bagdades/tester/tester/Sprint-Layout60_rus/titel.bmp

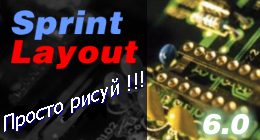
tester/Sprint-Layout60_rus/titel.bmp
