bagdades/tester/tester/RusPlan50/Titel.bmp

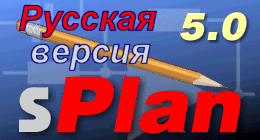
tester/RusPlan50/Titel.bmp
