bagdades/tester/(list of files, drawings)

Other design files:
tester/007.lay
tester/Sprint-Layout60_rus/MAKROS/ЭЛЕКТРО-ТЕХНИЧЕСКОЕ РАСПОЛОЖЕНИЕ ВЫВОДОВ/ПЕРЕХОДНИКИ/1.lay
