bagdades/tester/kicad/tester.kicad_pcb

## KiCad design kicad/tester.kicad_pcb (2018-04-10)

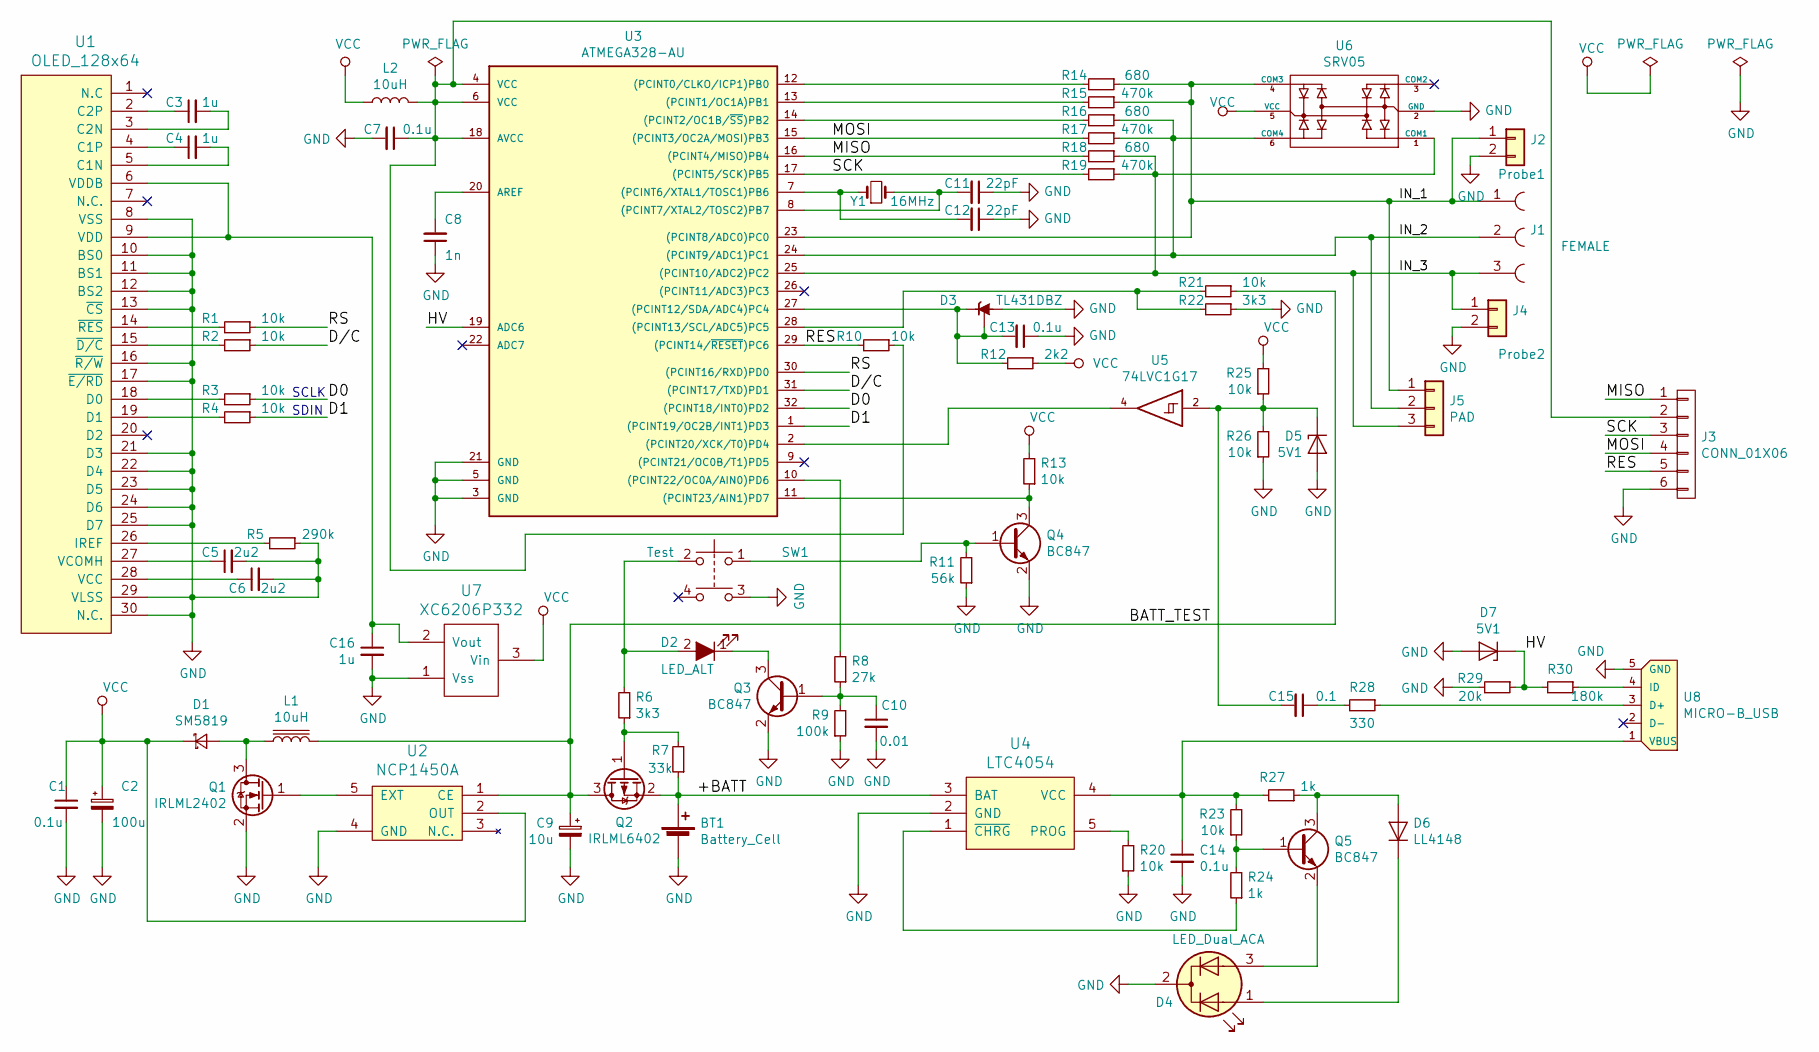
[picture p90: schematic tester.sch]

Parts:
BT1: Battery_Cell; PinHeader_1x02_P2.54mm_Vertical
C1, C7, C13, C14: 0.1u; C_0603_1608Metric
C2: 100u; c_tant_B
C3, C4, C16: 1u; C_0603_1608Metric
C5, C6: 2u2; C_0603_1608Metric
C8: 1n; C_0603_1608Metric
C9: 10u; c_tant_A
C10: 0.01; C_0603_1608Metric
C11, C12: 22pF; C_0603_1608Metric
C15: 0.1; C_0603_1608Metric
D1: SM5819; melf
D2: LED_ALT; LED_D3.0mm
D3: TL431DBZ; SOT-23
D4: LED_Dual_ACA; LED_D3.0mm-3
D5, D7: 5V1; D_MiniMELF
D6: LL4148; D_MiniMELF
J1: FEMALE; PinSocket_1x03_P2.54mm_Vertical
J2: Probe1; conn_tester
J3: CONN_01X06; avr_spi
J4: Probe2; conn_tester
J5: PAD; conn_threepoint
L1: 10uH; L_Coilcraft_XAL5030
L2: 10uH; L_0805_2012Metric
Q1: IRLML2402; SOT-23
Q2: IRLML6402; SOT-23
Q3, Q4, Q5: BC847; SOT-23
R1, R2, R3, R4, R10, R13, R20, R21, R23, R25, R26: 10k; R_0603_1608Metric
R5: 290k; R_0603_1608Metric
R6, R22: 3k3; R_0603_1608Metric
R7: 33k; R_0603_1608Metric
R8: 27k; R_0603_1608Metric
R9: 100k; R_0603_1608Metric
R11: 56k; R_0603_1608Metric
R12: 2k2; R_0603_1608Metric
R14, R16, R18: 680; R_1206_3216Metric
R15, R17, R19: 470k; R_1206_3216Metric
R24, R27: 1k; R_0603_1608Metric
R28: 330; R_0603_1608Metric
R29: 20k; R_0603_1608Metric
R30: 180k; R_0603_1608Metric
SW1: Test; BUT6120
U1: OLED_128x64; oled
U2: NCP1450A; SOT-23-5
U3: ATMEGA328-AU; TQFP-32_7x7mm_P0.8mm
U4: LTC4054; SOT-23-5
U5: 74LVC1G17; SOT-23-5
U6: SRV05; SOT-23-6
U7: XC6206P332; SOT-23
U8: MICRO-B_USB; USB_Micro-B_Molex_47346-0001
Y1: 16MHz; crystal_hc-49s

Connections:
/+BATT: BT1.1 (+), Q2.2 (S), R7.1, U4.3 (BAT)
/BATT_TEST: C9.1, L1.2, Q2.3 (D), R21.1, U2.1 (CE)
/D0: R3.1, U3.32 ((PCINT18/INT0)PD2)
/D1: R4.1, U3.1 ((PCINT19/OC2B/INT1)PD3)
/D/C: R2.1, U3.31 ((PCINT17/TXD)PD1)
/HV: D7.1 (K), R29.1, R30.2, U3.19 (ADC6)
/IN_1: J1.1, J2.1, J5.1, R14.1, R15.1, U3.23 ((PCINT8/ADC0)PC0), U6.4 (COM3)
/IN_2: J1.2, J5.2, R16.1, R17.1, U3.24 ((PCINT9/ADC1)PC1), U6.6 (COM4)
/IN_3: J1.3, J4.1, J5.3, R18.1, R19.1, U3.25 ((PCINT10/ADC2)PC2), U6.1 (COM1)
/MISO: J3.1, R18.2, U3.16 ((PCINT4/MISO)PB4)
/MOSI: J3.4, R17.2, U3.15 ((PCINT3/OC2A/MOSI)PB3)
/RES: J3.5, R10.2, U3.29 ((PCINT14/~RESET~)PC6)
/RS: R1.1, U3.30 ((PCINT16/RXD)PD0)
/SCK: J3.3, R19.2, U3.17 ((PCINT5/SCK)PB5)
GND: BT1.2 (-), C1.2, C2.2, C5.2, C6.2, C7.2, C8.1, C9.2, C10.2, C11.1, C12.1, C13.1, C14.2, C16.2, D3.3 (A), D4.2 (K), D5.2 (A), D7.2 (A), J2.2, J3.6, J4.2, Q1.2 (S), Q3.2 (E), Q4.2 (E), R5.1, R9.1, R11.1, R20.1, R22.1, R26.1, R29.2, SW1.3, U1.8 (VSS), U1.10 (BS0), U1.11 (BS1), U1.12 (BS2), U1.13 (~CS), U1.16 (~R/W), U1.17 (~E/RD), U1.21 (D3), U1.22 (D4), U1.23 (D5), U1.24 (D6), U1.25 (D7), U1.29 (VLSS), U1.30 (N.C.), U2.4 (GND), U3.3 (GND), U3.5 (GND), U3.21 (GND), U4.2 (GND), U5.3 (GND), U6.2 (GND), U7.1 (Vss), U8.5 (GND)
unnamed: C3.1, U1.2 (C2P)
unnamed: C3.2, U1.3 (C2N)
unnamed: C4.1, U1.4 (C1P)
unnamed: C4.2, U1.5 (C1N)
unnamed: C5.1, U1.27 (VCOMH)
unnamed: C6.1, U1.28 (VCC)
unnamed: C7.1, J3.2, L2.2, R10.1, U3.4 (VCC), U3.6 (VCC), U3.18 (AVCC)
unnamed: C8.2, U3.20 (AREF)
unnamed: C10.1, Q3.1 (B), R8.1, R9.2
unnamed: C11.2, U3.8 ((PCINT7/XTAL2/TOSC2)PB7), Y1.2
unnamed: C12.2, U3.7 ((PCINT6/XTAL1/TOSC1)PB6), Y1.1
unnamed: C13.2, D3.1 (K), D3.2 (REF), R12.2, U3.27 ((PCINT12/SDA/ADC4)PC4)
unnamed: C14.1, R23.2, R27.2, U4.4 (VCC), U8.1 (VBUS)
unnamed: C15.1, R28.2
unnamed: C15.2, D5.1 (K), R25.1, R26.2, U5.2
unnamed: C16.1, U1.6 (VDDB), U1.9 (VDD), U7.2 (Vout)
unnamed: D1.2 (A), L1.1, Q1.3 (D)
unnamed: D2.1 (K), Q3.3 (C)
unnamed: D2.2 (A), R6.2, SW1.2
unnamed: D4.1 (A1), D6.1 (K)
unnamed: D4.3 (A2), Q5.2 (E)
unnamed: D6.2 (A), Q5.3 (C), R27.1
unnamed: Q1.1 (G), U2.5 (EXT)
unnamed: Q2.1 (G), R6.1, R7.2
unnamed: Q4.1 (B), R11.2, SW1.1
unnamed: Q4.3 (C), R13.1, U3.11 ((PCINT23/AIN1)PD7)
unnamed: Q5.1 (B), R23.1, R24.2
unnamed: R1.2, U1.14 (~RES)
unnamed: R2.2, U1.15 (~D/C)
unnamed: R3.2, U1.18 (D0)
unnamed: R4.2, U1.19 (D1)
unnamed: R5.2, U1.26 (IREF)
unnamed: R8.2, U3.10 ((PCINT22/OC0A/AIN0)PD6)
unnamed: R14.2, U3.12 ((PCINT0/CLKO/ICP1)PB0)
unnamed: R15.2, U3.13 ((PCINT1/OC1A)PB1)
unnamed: R16.2, U3.14 ((PCINT2/OC1B/~SS~)PB2)
unnamed: R20.2, U4.5 (PROG)
unnamed: R21.2, R22.2, U3.28 ((PCINT13/SCL/ADC5)PC5)
unnamed: R24.1, U4.1 (~CHRG)
unnamed: R28.1, U8.3 (D+)
unnamed: R30.1, U8.4 (ID)
unnamed: U3.2 ((PCINT20/XCK/T0)PD4), U5.4
VCC: C1.1, C2.1, D1.1 (K), L2.1, R12.1, R13.2, R25.2, U2.2 (OUT), U5.5 (VCC), U6.5 (VCC), U7.3 (Vin)

Notes on the sheet:
SCLK
SDIN

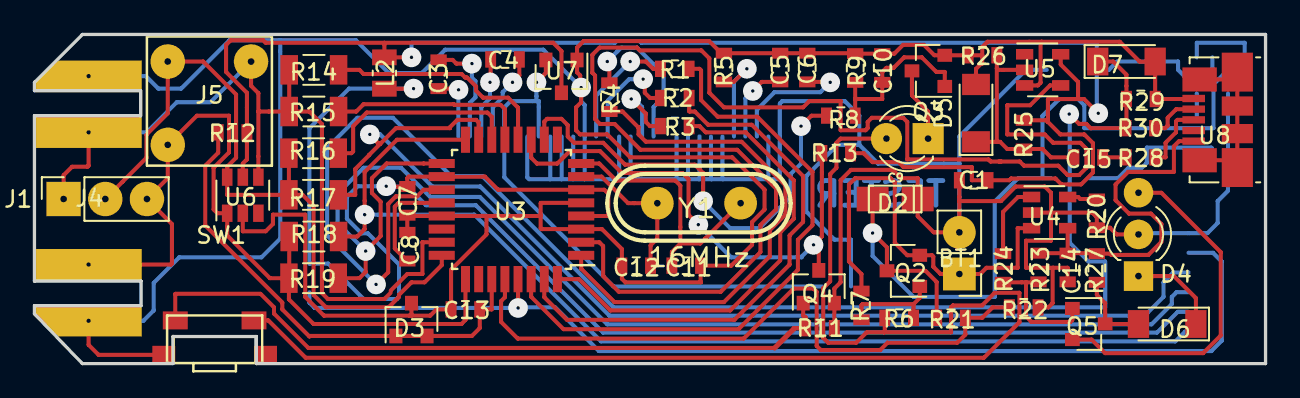
[picture p91: board tester.kicad_pcb from above]

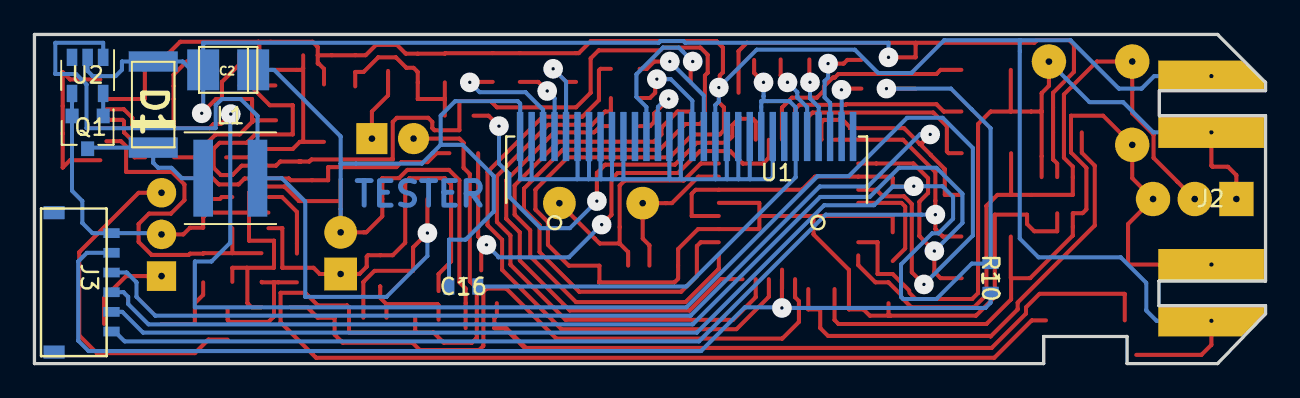
[picture p92: board tester.kicad_pcb from below]

Board: 2 copper layers, 75.1 x 20.1 mm, 76 parts (10 on the bottom side), 58 nets.
