bagdades/tester/04/24x32update_bitmaps.h

#include <avr/pgmspace.h>



//*****************************************************************************
//
// The data for the bitmap bmp_p_e_igbt
// update of the bitmap bmp_n_e_igbt at location 12,0
//
// Memory usage: 38 bytes
//*****************************************************************************
#if defined (MAIN_C)
 #if (ICON_TYPE == 1) /* Nick's thin icon update */
 const unsigned char bmp_p_e_igbt[(6 * 4) + 4] PROGMEM =
{ 
 17,
  0,
  6,
 32,
 /*0x00, 0x00, 0x00, 0x00,  0x00, 0x00, 0x00, 0x00, 
  0x00, 0x00, 0x00, 0x00,  0x1E, 0x21, 0x21, 0x21, 
  0x12,*/0x40, 0xC0, 0xC0,  0xC0, 0xC0, 0x20,/* 0x1F,
 
  0x00, 0x3C, 0x42, 0x52,  0x52, 0x34, 0x00, 0x00, 
  0x00, 0x00, 0x00, 0x00,  0xF8, 0x00, 0x00, 0xDE, 
  0x88,*/0x04, 0x02, 0x01,  0x03, 0x07, 0x00,/* 0x00,
 
  0x00, 0x04, 0x04, 0x04,  0x04, 0x04, 0x04, 0x04, 
  0x04, 0x04, 0x04, 0x04,  0x07, 0x00, 0x00, 0x3D, 
  0x08,*/0x11, 0xE2, 0xE4,  0xE0, 0x60, 0x20,/* 0x00,
 
  0x00, 0x00, 0x00, 0x00,  0x00, 0x00, 0x00, 0x00, 
  0x00, 0x00, 0x00, 0x00,  0xFC, 0x94, 0x94, 0x94, 
  0x84,*/0x00, 0x03, 0x01,  0x00, 0x01, 0x02,/* 0xFC */  
}; /* P-e-igbt = N-E-IGBT1 + UPDATE */

 #elif (ICON_TYPE == 2) /* Nick's bold icon update */
 const unsigned char bmp_p_e_igbt[(7 * 4) + 4] PROGMEM =
{ 
 15,
 0,
 7,
 32,
 /* 0x00, 0x00, 0x00, 0x00, 0x00, 0x00, 0x00, 0x00,
  0x00, 0x3E, 0x41, 0x41, 0x41, 0x22, 0x00,*/ 0x00,
  0x10, 0xB0, 0xF0, 0xF0, 0xF0, 0xF8,/* 0x0F, 0x07,

  0x00, 0x3C, 0x42, 0x52, 0x52, 0x34, 0x00, 0x00,
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

        0x00, 0x00, 0x00, 0x00,  0x00, 0x00, 0x00, 0x00,
        0x00, 0x00, 0x00, 0x00,  0x00, 0xfc, 0x94, 0x94,
        0x94, 0x84, 0x00, 0x01,  0x03, 0x07, 0xfe, 0xfc, */
}; /* PNP = NPN0 + UPDATE */

#endif
#else
 extern const unsigned char bmp_pnp[] PROGMEM ;
#endif
