bagdades/tester/04/sampling_lc.c

// original June-Sept 2015, pa3fwm@amsat.org

#ifdef SamplingADC

#include <avr/io.h>
#include <stdlib.h>
#include "Transistortester.h"

typedef uint8_t byte;

uint32_t lc_fx;      // measured resonant frequency (in Hz)
uint16_t lc_qx;      // measured resonance Q (in units of 0.1)
uint32_t lc_lx;      // measured inductance using the samplingADC method (in nH)
uint16_t lc_cpartmp; 
#ifndef CxL 
 #define CxL 18040			//default value for parallel capacitor for inductance measurement
#endif
const uint16_t lc_cpar_ee EEMEM = CxL;         // place for lc_cpar as calibration constant in eeprom




#define Maxpk 20

static unsigned int peaksearch(unsigned int uu[], unsigned int *qptr, byte dist, byte maxpk)
// searches uu[256] for peaks, using averaging over dist samples (dist should be about 1/4 of the expected period)
// writes measured Q *10 into *qptr if non-NULL
// maxpk is maximum number of peaks to take into account
// if maxpk<=2, indicates preliminary search mode, where dist may not yet be approximately correct; less stringent filtering then
// returns measured period, with 6 bits of fraction, or 0 if no resonance found
{  
   unsigned int a=0;  // moving average of previous dist points
   unsigned int b=0;  // moving average of next dist points
   byte i;        // index in uu[]
   byte ipk=0;    // peak count
   int prevdelta=1;
   unsigned int firstpeak=0;      // height of first peak
   unsigned int prevpeak=0;       // height of previous peak
   unsigned int sumpeak=0;        // sum of peaks
   unsigned int firstpeakx=0;     // time of first peak, with 6 bits of fraction
   unsigned int prevpeakx=0;      // time of previous peak, with 6 bits of fraction
   unsigned short firstzero=0;    // time of first zero, used for sanity check
   byte sawzero=0;                // flag: did we already encounter a zero?
//         uart_putc('d'); uart_int(dist); uart_newline();

   for (i=0;i<255-dist;i++) 
   {
      b+=uu[i+dist];
      a+=uu[i];
      if (i<dist) continue;
      a-=uu[i-dist];
      b-=uu[i];
      int delta=a-b;
      if (a==0) {
         sawzero=1;
         if (!firstzero) firstzero=i-dist;
      }
//         if (maxpk>2-2) { wdt_reset(); uart_putc('b'); uart_int(a); uart_int(b); uart_newline();}

      // note: uu[] can be assumed < 600 or so, since we're not interested in peaks above some 600 mV
      // with dist<=32 (because at least 2 periods must fit in 256 samples)
      // this means a and b cannot exceed about +20000, and cannot be negative
      // delta is between -20000 and 20000; near zero crossing delta can't exceed one uu[] value, i.e. +/- 600
      // delta can therefore safely be shifted <<6, but not <<8
      // hence the 6 bits of fraction in the peak location
      // on my atmega328p, in some cases most measured peak intervals differ by less than about 0.05, so 6 bits of fraction is just enough to not lose precision
      if (delta>0 && prevdelta<=0 && i>2*dist-1) {
         // found (local) maximum
//         myuart_putc('p'); myuart_putc(' ');  uart_int(i); uart_int(a+b); uart_int(dist); uart_newline();
         if (a+b < 3*dist) break;  // stop if peak not significantly high
         unsigned x = (i<<6) - ((delta<<6)+(1<<5))/(delta-prevdelta);
//         if (maxpk>2-2) { uart_putc('E'); uart_int(x); uart_int(ipk); uart_int(sawzero); uart_int(dist); uart_newline(); }

         sumpeak+=a+b;
         if (ipk==0) {
            firstpeak=a+b;
            firstpeakx=x;
         } else if (dist!=1) {
            // sanity check: distance between peaks is expected to be 4*dist samples, so if >=8*dist it's suspicious
            byte tmp;       // use this intermediate variable to force compiler to use 8-bit arithmetic
            tmp=x>>8;
            tmp-=prevpeakx>>8;    // tmp now is peak distance in units of 4 samples
            if (tmp>(dist<<1)) break;
         }
         if (!sawzero) {           // stop if the signal has not been zero since previous peak
            if (maxpk>2) break;
            else goto skip;        // if we're still in preliminary search mode: just skip this peak hoping we'll find a real one later
         }
         sawzero=0;
         prevpeak=a+b;
//         if (maxpk>2) { myuart_putc('e'); myuart_putc(' '); uart_int(x-prevpeakx); uart_int(a+b); uart_int(x>>6); uart_newline(); }
         prevpeakx=x;
         ipk++;
         if (ipk==maxpk) break;
      }
skip:
      prevdelta=delta;
   } /* end for i */

   if (qptr) {
      // calculate r = ratio of amplitude between two consecutive peaks (*1000 for scaling)
      // but we use all peaks seen in this calculation for better accuracy
      // r is weighted average of peak2/peak1, peak3/peak2 and so on, weighed by respectively peak1, peak2 and so on
      // this can be calculated as r = (peak2+peak3+...+peak_m)/(peak1+peak2+peak_{m-1})
      unsigned long int r=((sumpeak-firstpeak)*1000ul)/(sumpeak-prevpeak);
      // r = exp(-pi/Q)  so Q = -pi/(ln(r))
      // for r almost 1 (i.e., high Q), this is approx. pi/(1-r)
      r = 31416u/get_log(1000-r);
      // note scaling: the get_log is *1000, and we now compute Q in multiples of .1, hence the numerator being 10000*pi
      *qptr=(unsigned int)r;
   }
   if (ipk<2) return 0;		// only one or no peak found
   ipk--;
   unsigned int per= (prevpeakx-firstpeakx+(ipk>>1))/ipk;   // average period; the (ipk>>1) provides for rounding
   if (firstzero>(per>>6)) return 0;     // sanity check: first zero should be within first period
   return per;
}  /* end of peaksearch */




void sampling_lc(byte LowPin, byte HighPin)
{
   uint16_t lc_cpar;    // value of parallel capacitor used for calculating inductance, in pF
   lc_cpar=eeprom_read_word((uint16_t *)&lc_cpar_ee);

//###################################################################################################
//#ifndef SamplingADC_CNT             // old version of the code
#if 0

   byte HiPinR_L, LoADC;
   HiPinR_L = pgm_read_byte(&PinRLRHADCtab[HighPin]);	//R_L mask for HighPin R_L load
#if (((PIN_RL1 + 1) != PIN_RH1) || ((PIN_RL2 + 1) != PIN_RH2) || ((PIN_RL3 + 1) != PIN_RH3))
   LoADC = pgm_read_byte((&PinRLRHADCtab[6])+LowPin) | TXD_MSK;
#else
   LoADC = pgm_read_byte((&PinRLRHADCtab[3])+LowPin) | TXD_MSK;
#endif

   lc_fx=0;
   lc_qx=0;
   lc_lx=0;
   if ((PartFound != PART_RESISTOR) || (inductor_lpre > 0)) {
      // can happen if we're invoke when there's both a diode and a resistor;
      // don't try to measure inductance then
      // the other reason is a too big resistance, 2100 Ohm is found by ReadInductance
      return;
   }

   byte i=0;

   unsigned int uu[257];
   ADC_PORT = TXD_VAL;
   ADC_DDR = LoADC;			// switch Low-Pin to output (GND)
   wait100us();


   // first, acquire data at maximum speed:
#if (PROCESSOR_TYP == 644) || (PROCESSOR_TYP == 1280)
   ADMUX=HighPin|(0<<REFS0)|(1<<REFS1);   // use built-in reference, about 1.1 V;
#else
   ADMUX=HighPin|(1<<REFS0)|(1<<REFS1);   // use built-in reference, about 1.1 V;
   // that's enough, because peaks more than about 0.6 V are not of interest
   // (because the negative peak would be chopped by the protection diodes)
#endif
#ifdef NO_AREF_CAP
    wait100us(); /* time for voltage stabilization */
#else
    wait_about10ms(); /* time for voltage stabilization */
#endif
    samplingADC(0, uu, 0, HiPinR_L, 0, HiPinR_L, HiPinR_L);     // floats the HiPin during measurement, thus not loading the tuned circuit
//   uart_newline(); for (i=0;i<255;i++) { uart_putc('A'); uart_putc(' '); uart_int(uu[i]); uart_newline(); wdt_reset(); }

   byte dist0;
   unsigned shift=0;
   // check how long until signal reaches 0: that gives us a first guess of 1/4 of the resonance period (because we apply an impulse, so we start at the maximum of the sinewave)
   for (dist0=2;dist0<250;dist0++) if (uu[dist0]==0) break;
   if (dist0==250) {
      // no periodicity seen, so no valid results
//      lc_lx=0;
//      lc_fx=0;
//      lc_qx=0;
      return;
   }

   dist0--;                 // improves estimate slightly (experimentally)
   uint16_t par = samplingADC_twopulses | (4<<smplADC_inter_pulse_width); // default: two pulses at minimal distance
   if (dist0<=6*3) {
      // in case of rather small dist0, need to measure dist0 more precisely, by simply invoking the peaksearch function
      unsigned int full_per;
retry:
      full_per=peaksearch(uu,NULL,dist0,2);
//         uart_putc('p'); uart_int(per); uart_newline();
      if (full_per==0) {   // not at least 2 peaks found: try with smaller dist0, or give up
                      // reason for trying with small dist0 is that with very small inductors, zero is often not reached before the first peak, making the zeroth peak look much too wide, causing overestimate of dist0
                      // perhaps should no longer use that for estimating dist0...
         if (dist0>2) { dist0=2; goto retry; }
         return;  
      }
      dist0= 1+(full_per>>8);    // >>6 because of fraction bits, plus >>2 because dist0 should be about a quarter period, plus +1 since 2 turns out to work better than 1 even on very fast signals (2 MHz or so)
      full_per>>=6;
      if (full_per<=15) {
         // for high frequencies, we can send 2 pulses at the appropriate interval
         // (for lower frequencies, we just keep them at their default minimum distance)
         if (full_per<4) full_per=4;
         par = samplingADC_twopulses | (((byte)full_per)<<smplADC_inter_pulse_width);
      }
   }
//   uart_newline(); for (i=0;i<255;i++) { uart_putc('a'); uart_putc(' '); uart_int(uu[i]); uart_newline(); wdt_reset(); }
	
   if (dist0>16) {
      // rather slow resonance: then re-sample with 4 or 16 times larger interval; shift variable serves to take this into account in later calculations
      if (dist0<64) {
         shift=2;
         par = samplingADC_slow4 | samplingADC_twopulses | (4<<smplADC_inter_pulse_width);
      } else {
         shift=4;
         par = samplingADC_slow16 | samplingADC_twopulses | (4<<smplADC_inter_pulse_width);
      }
      dist0>>=shift;
   }
   // we take the average of 8 measurements, to increase S/N, except when using slow16 mode, since then the sampling would take annoyingly long (and S/N usually is better anyway at these lower frequencies)
   
//      par |= samplingADC_cumul;
   for (i=0;i<8;i++) {
      wdt_reset();
      samplingADC(par, uu, 0, HiPinR_L, 0, HiPinR_L, HiPinR_L);
      if (par & samplingADC_slow16) goto noavg;
      par |= samplingADC_cumul;
   }
   for (i=0;i<255;i++) uu[i]>>=3;   // divide all samples by 8

#ifndef SamplingADC_CNT
noavg:;
#endif
//***************************************************************************************************
#if (DEB_SAM == 2)
   uint16_t ii;
//   for (ii=0;ii<256;ii+=4) {
   for (ii=0;ii<64;ii+=4) {
      if ((ii%32) == 0) {
         lcd_clear();
	 DisplayValue16(ii,0,'-',4);
	 lcd_space();
	 lcd_data('>');
	 lcd_data('>');
	 DisplayValue16(shift,0,' ',3);
	 DisplayValue16(par>>smplADC_inter_pulse_width,0,' ',3);
	 lcd_next_line_wait(0);
      } else{	 	lcd_next_line_wait(0); }
      DisplayValue16(uu[ii],0,' ',5);
      DisplayValue16(uu[ii+1],0,' ',5);
      DisplayValue16(uu[ii+2],0,' ',5);
      DisplayValue16(uu[ii+3],0,' ',5);
      if ((ii%32) == 28) {
	 lcd_clear_line();
	 lcd_refresh();
         wait_about5s();
      }
   } /* end for ii */
#endif
//***************************************************************************************************

//   uart_newline(); uart_putc('s'); uart_int(shift); uart_newline();  for (i=0;i<255;i++) { uart_putc('a'); uart_putc(' '); uart_int(uu[i]); uart_newline(); wdt_reset(); }

//         uart_putc('d'); uart_int(d); uart_newline();

//###################################################################################################
#else  // new version of the code, with pulses via the ADC port, i.e., without 680 ohm series resistor

   byte HiPinR_L, LoADC;
   HiPinR_L = pinmaskRL(HighPin);
   LoADC = pinmaskADC(LowPin);

   lc_fx=0;
   lc_qx=0;
   lc_lx=0;
   if ((PartFound != PART_RESISTOR) || (inductor_lpre > 0)) {
      // can happen if we're invoke when there's both a diode and a resistor;
      // don't try to measure inductance then
      // the other reason is a too big resistance, 2100 Ohm is found by ReadInductance
      return;
   }

   byte i=0;

   unsigned int uu[255];


   ADC_PORT = TXD_VAL;
   ADC_DDR = LoADC;			// switch Low-Pin to output (GND)
   wait100us();

   // first, acquire data at maximum speed:
   ADMUX=HighPin|ADref1V1;   // use built-in reference, about 1.1 V;
                             // that's enough, because peaks more than about 0.6 V are not of interest
                             // (because the negative peak would be chopped by the protection diodes)
   wait_aref_stabilize();                               

   // run a first measurement, using the narrow full-current impulse
   samplingADC((1<<smplADC_span)|(1<<smplADC_direct), uu, 255, HiPinR_L, 0, 0, HiPinR_L);

   // also measure some 20 samples at the "cold side" of the coil, and subtract
   // at highest frequencies, this is useful because the on-chip ADC has an RC lowpass which gives an exponentially decaying "DC" offset
   unsigned int uu0[20];
   ADMUX=LowPin|ADref1V1;   // switch to "cold" side for reference measurement
   samplingADC((1<<smplADC_span)|(1<<smplADC_direct), uu0, 20, HiPinR_L, 0, 0, HiPinR_L);
   for (i=0;i<20;i++)
   {
      if (uu[i]>=uu0[i]) uu[i]-=uu0[i];
      else uu[i]=0;
   }
   ADMUX=HighPin|ADref1V1;   // back to "hot" side

//   uart_newline(); for (i=0;i<255;i++) { myuart_putc('A'); myuart_putc(' '); uart_int(uu[i]); uart_int(uu0[i]); uart_newline(); wdt_reset(); }

   byte dist0;         // estimate of duration of 1/4 of a period, used to set averaging interval in peaksearch()
   unsigned shift=0;   // by how many bit positions measured period needs to be shifted due to measuring with span>1

   // check how long until signal reaches 0: that gives us a first guess of 1/4 of the resonance period (because we apply an impulse, so we start at the maximum of the sinewave)
   for (dist0=1;dist0<250;dist0++) if (uu[dist0]==0) break;
   if (dist0==250) return; // no periodicity seen, so no valid results
#if (DEB_SAM == 5)
   byte dist00;
   dist00 = dist0;
#endif

   uint16_t par = (1<<smplADC_span) | (1<<smplADC_direct); // default: one pulse 
   if (dist0<=16) {
      // in case of small dist0, need to measure dist0 more precisely, by simply invoking the peaksearch function
      // this includes the case dist0==0, which may happen with very small coils, when the response starts at 0 rather than with a peak
      unsigned int full_per;
      full_per=peaksearch(uu,NULL,dist0,2);
//       { myuart_putc('D'); myuart_putc(' '); uart_int(dist0); uart_int(full_per); uart_newline(); }
      dist0= 1+(full_per>>8);    // >>6 because of fraction bits, plus >>2 because dist0 should be about a quarter period, plus +1 to round up
   }
//   { myuart_putc('d'); myuart_putc(' '); uart_int(dist0); uart_newline(); }
	
#define samplingADC_direct (1<<smplADC_direct)
   par = (1<<smplADC_span) | samplingADC_direct;
   if (dist0>16) {
      // rather slow resonance: then re-sample with 4 or 16 times larger interval; shift variable serves to take this into account in later calculations
      if (dist0<64) {
         shift=2;
         par = (4<<smplADC_span) | samplingADC_direct;
//         par = 3 | (4<<smplADC_span);
      } else {
         shift=4;
         par = (16<<smplADC_span) | samplingADC_direct;
//         par = 15 | (16<<smplADC_span);
      }
      dist0>>=shift;
   }
#if (DEB_SAM == 5)
   uint16_t ii;
//   for (ii=0;ii<256;ii+=4) {
   for (ii=0;ii<255;ii+=4) {
      if ((ii%32) == 0) {
         lcd_clear();
	 DisplayValue16(ii,0,'-',4);
	 lcd_space();
	 lcd_data('>');
	 lcd_data('>');
	 DisplayValue16(shift,0,' ',3);
         DisplayValue16(dist0,0,' ',4);
         DisplayValue16(dist00,0,' ',4);
	 lcd_next_line_wait(0);
      } else{	 	lcd_next_line_wait(0); }
      DisplayValue16(uu[ii],0,' ',5);
      DisplayValue16(uu[ii+1],0,' ',5);
      DisplayValue16(uu[ii+2],0,' ',5);
      DisplayValue16(uu[ii+3],0,' ',5);
      if ((ii%32) == 28) {
	 lcd_clear_line();
	 lcd_refresh();
         wait_about1s();
      }
   } /* end for ii */
   lcd_refresh();
   wait_about1s();
#endif

   // we take the average of 8 measurements, to increase S/N, except when using span>1, since then the sampling takes annoyingly long and S/N usually is better anyway at these lower frequencies
   for (i=0;i<8;i++) {
      wdt_reset();
      samplingADC(par, uu, 255, HiPinR_L, 0, 0, HiPinR_L);
      if (par >> (smplADC_span+1)) goto noavg;
      par |= samplingADC_cumul;
   }
//   if (dist0<4) {  // note that dist0<4 implies shift==0 by the above code
   if ((par >> smplADC_span) < 4) {
      // case of high frequency: subtract reference measurement, and do no scaling down of accumulated amplitudes since they are small in this case
      ADMUX=LowPin|ADref1V1;   // switch to "cold" side for reference measurement
      par &= ~samplingADC_cumul;
      for (i=0;i<8;i++) {
         samplingADC(par, uu0, 20, HiPinR_L, 0, 0, HiPinR_L);
         par |= samplingADC_cumul;
      }
      i=20; while (i--)         // equivalent to for (i=0;i<20;i++) but saves 48 bytes of flash????
      {
         if (uu[i]>=uu0[i]) uu[i]-=uu0[i];
         else uu[i]=0;
      }
   } else {
      // low frequency: no reference measurement needed, but do scale amplitude by number of accumulated samples
      i=255;
      while (i--) uu[i]>>=3;   // divide all samples by 8
   }

//   uart_newline(); for (i=0;i<255;i++) { myuart_putc('a'); myuart_putc(' '); uart_int(uu[i]); uart_newline(); wdt_reset(); }

noavg:;
//   { myuart_putc('d'); myuart_putc(' '); uart_int(dist0); uart_newline(); }


#endif
//###################################################################################################

   // calculation of the results:
   // d= distance between peaks (in units of CPU clock tics)
   //
   // L = 1/C/(2*pi*fclock/d)**2
   //   = 1/C/(2*pi*fclock)**2 * (d**2)
   //   = 1/(2*pi*fclock)**2 / C * (d**2)

   unsigned period=peaksearch(uu,&lc_qx,dist0,Maxpk);
//   { myuart_putc('d'); myuart_putc(' '); uart_int(dist0); uart_int(period); uart_newline(); }

   unsigned long v;
   v= (unsigned long)period;         // measured period with 6 fraction bits, before applying shift, is < 256*64 = 2^14
   v=v*v;                            // v < 2^28   ; this is (except for shift)  d<<12
#if F_CPU==16000000UL
//   v=(v>>10)*12368;		// v < 2^32   ; is (d<<2)/(2*pi*fclock)^2 * 1e21 >>3
				// that 12368 is calculated as 1/(2*pi*16e6)**2*1e21 /8, for 16 MHz CPU clock
				// 1e21 / (2*pi*16e6)**2 / (8 * 1024)      = 12.07842632, which can be computed
				// with a divide by 51 and a mul with 616 (= 12.07843137) .
				// whith better accuracy than   12368/1024 = 12.07812500
   v = (v/51)*616;
#elif F_CPU==8000000UL
//   v=(v>>12)*49473;		// for 8 MHz CPU clock, it's 49473, but we need to right-shift further to fit in 32 bit
				// 1e21 / (2*pi*16e6)**2 / (8 * 1024)      = 12.07842632, which can be computed
				// with a divide by 51 and a mul with 616 (= 12.07843137) .
				// whith better accuracy than   49473/4096 = 12.07836914
   v = (v/51)*616;
   shift++;                          // change shift variable to compensate for that later on
#else
   #error "CPU clocks other than 8 and 16 MHz not yet supported for SamplingADC"
   v=0;
#endif
//   v/=lc_cpar;                          //          ; is (d<<2)/(2*pi*fclock)^2/c * 1e9 >>3
   v/=(lc_cpar>>1);                          //          ; is (d<<2)/(2*pi*fclock)^2/c * 1e9 >>2
	// shift for 16 MHz 0, 2,  4; for 8 MHz 1, 3,  5
        // resulting factor 2,32,512            8,128,2048 
//   v<<=1+2*shift;                      //          ; is L in 1e-9 H  
   v<<=2*shift;                      //          ; is L in 1e-9 H  
                        // not nice: the nH number will always be even; then again, do we really measure that precisely?
   lc_lx=v;


   // check whether this estimate is plausible
   // probably inductor_lpre should be checked:
   // inductor_lpre = 0, no Inductor found 
   // unductor_lpre = 1,  rx is above 2100 Ohm
   // inductor_lpre = -5, Inductance searched without 680 Ohm, rx is below 24 Ohm
   // inductor_lpre = -4,  Inductance is searched with 680i Ohm, 24 < rx < 2100
   // probably search of 
   if (inductor_lx>2) {
      // if traditional measurement gave some meaningful-looking value ( > 20 uH, but that's rather arbitrary)
      // discard the new one, it's probably self-resonance
      // note that if a sizeable cap is in parallel, the normal measurement doesn't come up with an answer
      lc_lx=0;
   }

   // freq/Hz = F_CPU/d
   if (period==0) {
      lc_qx = 0;
      lc_lx = 0;
#if (DEB_SAM == 3)
   uint16_t ii;
//   for (ii=0;ii<256;ii+=4) {
   for (ii=0;ii<128;ii+=4) {
      if ((ii%32) == 0) {
         lcd_clear();
	 DisplayValue16(ii,0,'-',4);
	 lcd_space();
	 lcd_data('>');
	 lcd_data('>');
	 DisplayValue16(shift,0,' ',3);
         DisplayValue16(dist0,0,' ',4);
	 lcd_next_line_wait(0);
      } else{	 	lcd_next_line_wait(0); }
      DisplayValue16(uu[ii],0,' ',5);
      DisplayValue16(uu[ii+1],0,' ',5);
      DisplayValue16(uu[ii+2],0,' ',5);
      DisplayValue16(uu[ii+3],0,' ',5);
      if ((ii%32) == 28) {
	 lcd_clear_line();
	 lcd_refresh();
         wait_about5s();
      }
   } /* end for ii */
   lcd_refresh();
   wait_about5s();
#endif
      return;
   }
#if F_CPU==16000000UL
   v= (unsigned long)period<<1;
#else
   v= (unsigned long)period;
#endif
   lc_fx=((F_CPU<<(7-shift))/v);

   if (inductor_lpre >= 0) inductor_lpre = -1; 	/* no ESR measurement! */
   return;
} /* end of sampling_lc() */




void sampling_lc_calibrate()
{
   lcd_clear();
   lcd_MEM2_string(cap_for_l_meas_str);		// "Cap for L meas?"
   byte i=0;
   byte ww=0;
   do { 
      lc_cpartmp=0;
      wait_about100ms();
      ReadCapacity(TP1,TP3);
      lcd_line2();
      DisplayValue16(lc_cpartmp,-12,'F',4);
      i++;
      if ((lc_cpartmp<9500) || (lc_cpartmp>33000)) i=0;		// unstable or not connected
      if (i > 4) {	// Cx measurement was stable
         eeprom_write_word((uint16_t *)&lc_cpar_ee,lc_cpartmp);
	 lcd_space();
         lcd_MEM_string(OK_str);	// Output "OK"
         lcd_refresh();
         wait_about500ms();
         break;
      }
      lcd_clear_line();
      lcd_refresh();
   } while (++ww != 0);
//   if (i <= 4) {
//      lcd_line2();
//      lcd_MEM2_string(NotFound_str);		// "Not found!"
//      lcd_clear_line();
//      wait_about1s();			// time to read the Not found message
//   }
//   wait_for_key_5s_line2();
}


#endif   // SamplingADC
