bagdades/tester/(commit log)

2017-04-09 First add
    [taghl_config.txt, tester.kicad_pcb, tester.sch]
2017-04-10 Change package some resistors
    [tester.kicad_pcb, tester.sch]
2017-04-11 Add footprint oled
    [tester.kicad_pcb, tester.sch]
2017-04-28 Update pcb
    [tester.kicad_pcb, tester.sch]
2017-06-05 Start pcb routing
    [tester.kicad_pcb, tester.sch]
2017-06-08 Change to92 3d settings
    [tester.kicad_pcb]
2017-06-08 Continue work with pcb
    [tester.kicad_pcb, tester.sch]
2017-06-14 Correction pcb on work
    [tester.kicad_pcb]
2017-11-09 Working with pcb
    [tester.kicad_pcb, tester.sch]
2018-03-19 Recovery pdb start
    [007.lay, 1.lay, tester-2018-03-18-18-43-54.sch, tester.kicad_pcb, tester.sch]
2018-03-31 Prefinal PCB
    [tester.kicad_pcb, tester.sch]
2018-04-01 Final PCB
    [tester.csv, tester.kicad_pcb, tester.sch]
2018-04-10 Final correct and output
    [tester.kicad_pcb, tester.sch]
