bagdades/tester/(notices)

Notices in the files:
04/autoconf.h:
CC0 defines the capacity of empty terminal pins 1 & 3 without cable
